loboblancoelbellos/WRO-Competencia-Cayapa/modelado 3d/Soporte para servomotor delantero.jpeg

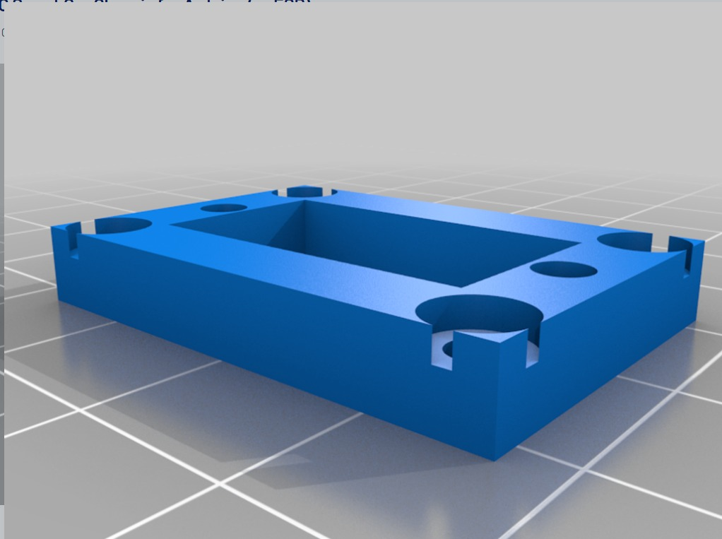
modelado 3d/Soporte para servomotor delantero.jpeg
