loboblancoelbellos/WRO-Competencia-Cayapa/Foto/FOTOGRUPAL.jpeg

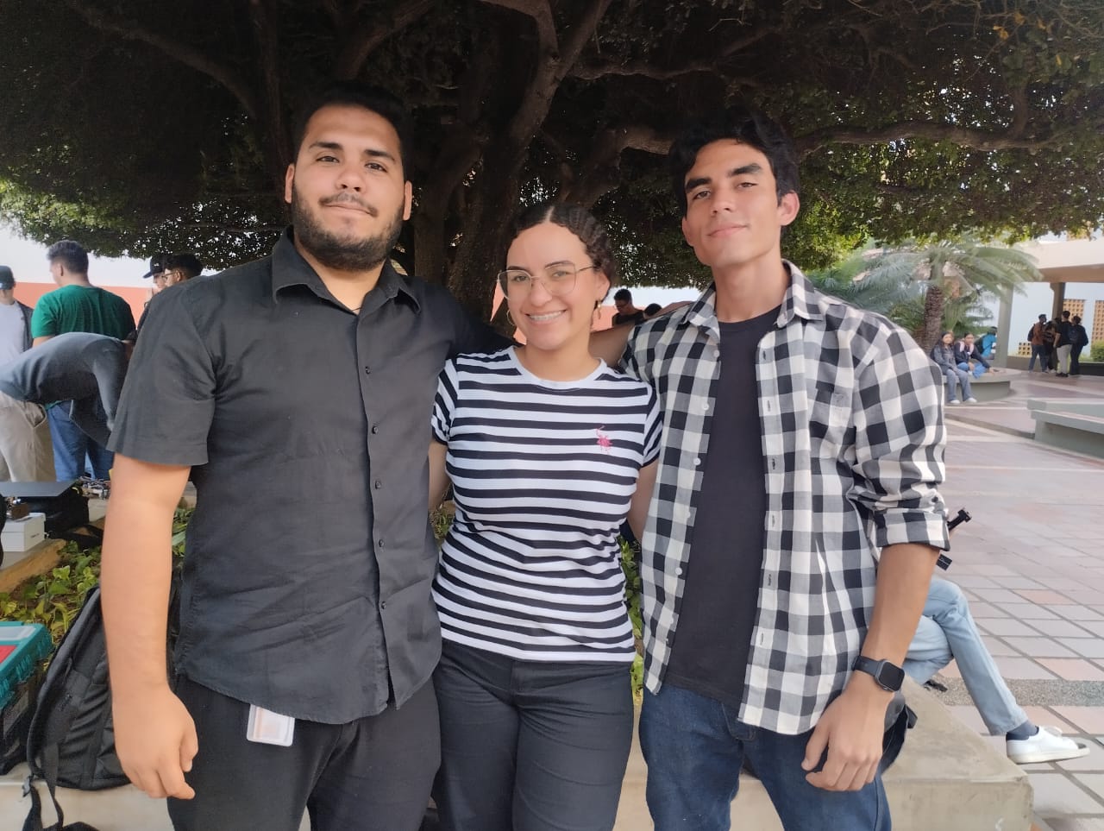
Foto/FOTOGRUPAL.jpeg
