loboblancoelbellos/WRO-Competencia-Cayapa/README.md

# 🚀 WRO 2026 Future Engineers: Equipo Cayapa - Robot "Dinoco"

equipo cayapa2026-09-06 at 17 40 40

> *Vehículo autónomo de diseño compacto desarrollado por el equipo **Cayapa** para competir en la categoría Future Engineers de la World Robot Olympiad (WRO) 2026. Diseñado para optimizar el radio de giro, la estabilidad estructural y la velocidad de procesamiento mediante un microcontrolador ESP32 y una matriz de sensores ultrasónicos.*

---

## 📌 ÍNDICE
1. Introducción y Datos del Equipo
2. Evolución e Iteraciones del Diseño Mecánico
3. Movilidad y Sistema de Tracción/Dirección
4. Arquitectura de Hardware, Sensores y Energía
5. Dimensiones de la Pista y Estrategia de Control
6. Análisis de Fallas, Riesgos y Lecciones Aprendidas
7. Guía de Reproducibilidad y Archivos del Repositorio

---

## 👥 1. Introducción y Datos del Equipo

Este repositorio documenta el desarrollo integral de nuestro vehículo autónomo **"Dinoco"**. Como estudiantes de Ingeniería en Electrónica, aplicamos principios de control automático, diseño mecánico e integración de sistemas electromecánicos para cumplir con la estricta normativa oficial de la WRO 2026.

### Miembros del Equipo

* **Dharma Alexandra Peña Jimenez** - *Tutora y Directora del Proyecto*
  Encargada de la planificación estratégica, gestión de recursos y supervisión general. Su liderazgo fue clave para mantener al equipo enfocado en los objetivos técnicos y asegurar el cumplimiento del cronograma de cara a la competencia.

* **Leontino Jose Medina Di Donato** - *Diseño Mecánico, Modelado e Impresión 3D*
  Especialista en CAD y manufactura aditiva. Su trabajo se centró en la optimización topológica del chasis, la reducción del volumen para mejorar el radio de giro y el diseño de piezas con tolerancias milimétricas para integrar el sistema de rodamientos.

* **Adriana Carolina Palmar Molero** - *Diseño de Circuitos, Sistema de Potencia y Cableado*
  Responsable de la arquitectura de hardware. Desarrolló el diagrama esquemático, seleccionó los componentes de regulación térmica (Buck Converter, Level Shifter) y garantizó un ruteo de cables limpio, seguro y resistente a las vibraciones de la pista.

* **Nilecto Noe Leon Guerere** - *Desarrollo de Software y Algoritmos de Control*
  Arquitecto del código fuente. Aprovechó la capacidad del ESP32 para implementar un control PID de alta frecuencia, diseñando algoritmos de filtrado de señales ultrasónicas para garantizar una navegación fluida, reactiva y 100% autónoma.

---

## 🔄 2. Evolución e Interaciones del Diseño Mecánico

El desarrollo de *Dinoco* ha sido un proceso estrictamente iterativo, donde cada modificación respondió a fallas diagnosticadas durante pruebas dinámicas en pista.

### 2.1. Prototipo 1.0: Chasis RC Modificado y Arquitectura Basada en Arduino Mega

**Motivación y Selección Mecánica Inicial (Ciclo 2025)**

Debido a las restricciones de tiempo en la fase inicial del proyecto para las competencias de 2025, el equipo optó por no diseñar un chasis desde cero. En su lugar, se seleccionó como plataforma de pruebas un chasis comercial de radiocontrol (RC) de dimensiones iniciales de 45 cm de largo por 20 cm de ancho. Para adecuarlo al reglamento de esa temporada, se redujo la longitud recortando la estructura central.

Sistema de Tracción: Transmisión por eje posterior rígido hacia ambas ruedas traseras.

Sistema de Dirección: Servomotor MG995, seleccionado por su elevado par de apriete (torque).

**Diagnóstico Crítico de Fallas (¿Por qué se descartó el Prototipo 2025 para el diseño actual?)**

Evaluar el rendimiento de este primer prototipo fue fundamental para sentar las bases mecánicas y electrónicas del modelo que competirá este año. Las principales deficiencias documentadas fueron:

Radio de Giro Ineficiente: Con dimensiones cercanas al límite máximo, el vehículo requería un radio de viraje sumamente amplio, siendo incapaz de completar curvas de 90° cerradas o ejecutar el estacionamiento autónomo.

Ruido Inductivo (Back-EMF): El servomotor MG995 inyectaba picos de corriente hacia el pin de señal del Arduino Mega, provocando bloqueos aleatorios del programa.

Sobrecarga Térmica y Caídas de Tensión (Brownouts): El regulador LM7805 sufría sobrecalentamiento por la demanda simultánea de los sensores y el servo, ocasionando lecturas erráticas y reinicios constantes.

---

### 2.2. Dinoco (Versión 2.0 / Actual): Optimización Dimensional y Upgrade Electrónico

Tras analizar las limitaciones mecánicas y eléctricas del Prototipo 1.0, rediseñamos la plataforma desde cero para crear **Dinoco 2.0**, enfocándonos en la ergonomía, la velocidad de procesamiento y la modularidad.

**Vista del Chasis Actual:**
-
carrito 2026-09-06 at 17 45 28

---
**Ensamblaje de Componentes:**

adriana ensamblando 2026-09-06 at 17 45 37

---

leontino ensamblando 2026-09-06 at 17 44 20

---

WhatsApp Image 2026-09-06 at 21 21 08

---

* **Reducción Ergonométrica:** La longitud pasó de 45 cm a un tamaño compacto entre **23 cm y 25 cm**, y el ancho se optimizó a **15 cm**. Esta disminución drástica del volumen mejora significativamente la maniobrabilidad del robot dentro de los carriles de la pista.
* **Dirección Simplificada con Rodamientos:** Se rediseñó el tren delantero integrando **rodamientos (rolineras)** en las manguetas de dirección. Esto reduce drásticamente la fricción mecánica y elimina el juego holgado.
* **Migración al ESP32 + Shield Expansor:** Reemplazamos el Arduino Mega por un **ESP32** montado sobre una placa de expansión de pines, aprovechando su arquitectura Dual-Core a 240 MHz para el procesamiento del algoritmo PID.

---

## ⚙️ 3. Movilidad y Sistema de Tracción/Dirección

### 3.1. Tracción Trasera: Motor DC Makeblock 9V (185 RPM)
Motor Makeblock

* **Justificación de Selección:** Proporciona un **alto par motor (torque)** gracias a su caja reductora metálica, manteniendo constante la tracción de las ruedas traseras.
* **Control de Velocidad:** Gobernado a través de señales PWM mediante el controlador Puente H L298N.

### 3.2. Dirección delantera tipo Ackermann con Rodamientos


* **Mecanismo:** Geometría Ackermann equipada con **rodamientos (rolineras)** en los puntos de pivote para minimizar el rozamiento.
* **Actuador:** Servomotor **MG90S con engranajes metálicos**, evitando desgastes por colisión y garantizando un ángulo de giro suave y rápido.

---

## 🔌 4. Arquitectura de Hardware, Sensores y Energía

Para el diseño de **Dinoco 2.0**, realizamos una reestructuración completa de los componentes electrónicos y electromecánicos, basándonos en un análisis de compensaciones (*Trade-offs*).

### 4.1. Unidad de Procesamiento Central (Cerebro)

**ESP32 (Placa de Desarrollo 30 Pines)**

ESP32

* **Función y Ubicación:** Es el cerebro del robot, encargado de ejecutar el control PID y procesar los sensores. Va ubicado en la parte superior del chasis para evitar interferencias.
* **Por qué se cambió:** Reemplaza al Arduino Mega del Prototipo 1.0 (lento y grande). El ESP32 nos da procesamiento Dual-Core a 240 MHz.
* **Ventajas:** Alta velocidad de reloj, conectividad inalámbrica para futura telemetría y tamaño sumamente compacto.
* **Desventajas:** Opera con lógica de 3.3V (a diferencia de los 5V del Arduino), lo que nos obligó a rediseñar la electrónica de sensores para evitar quemar sus pines.

**Shield Expansor para ESP32 (30 Pines)**



* **Función y Ubicación:** Base donde se acopla el ESP32, expandiendo sus pines GPIO a borneras y conectores macho.
* **Por qué se implementó:** En el carro anterior, las conexiones directas o en protoboard generaban falsos contactos con las vibraciones.
* **Ventajas:** Facilita el cableado con terminales Dupont, organiza la distribución de energía y permite sustituir el ESP32 en segundos en caso de falla en los pits.
* **Desventajas:** Aumenta ligeramente la altura de la electrónica principal.

### 4.2. Adaptación y Regulación de Energía

**Conversor de Nivel Lógico (Level Shifter Bidireccional)**



* **Función y Ubicación:** Interfaz colocada entre los sensores ultrasónicos y el ESP32.
* **Por qué se implementó:** El ESP32 solo soporta 3.3V en sus entradas, pero el pin Echo de los sensores ultrasónicos envía pulsos de 5V. 
* **Ventajas:** Protege los pines GPIO del microcontrolador de sobretensiones irreversibles, traduciendo de 5V a 3.3V de forma segura.
* **Desventajas:** Añade complejidad al cableado del esquemático y requiere ser alimentado con ambos voltajes simultáneamente.

**Regulador de Voltaje LM2596 (Buck Converter / Step-Down)**



* **Función y Ubicación:** Reduce el voltaje de las baterías (11.1V) a un bus estable y seguro de 5V para la lógica y sensores.
* **Por qué se cambió:** Reemplaza al regulador lineal LM7805 del Prototipo 1.0 que se sobrecalentaba y apagaba el robot.
* **Ventajas:** Al ser un regulador conmutado, tiene una eficiencia de hasta 92%, no se sobrecalienta fácilmente y permite ajustar el voltaje.
* **Desventajas:** Puede introducir un leve ruido de conmutación de alta frecuencia en la línea de alimentación.

**Baterías 18650 (x3) y Portabaterías (Holder)**

Baterías 18650

* **Función y Ubicación:** Fuente de energía principal. Alojadas en la parte inferior trasera del chasis para mantener el centro de gravedad bajo.
* **Por qué se eligieron:** Proveen **11.1V nominales**. Su alta capacidad de descarga soporta los picos de arranque del motor trasero sin causar reinicios en el procesador.
* **Ventajas:** Recargables, altísima densidad energética y mantienen un voltaje estable por más tiempo.
* **Desventajas:** Requieren un cargador especializado y balanceo de celdas; un cortocircuito puede ser peligroso.

### 4.3. Actuadores y Mecánica de Tracción

** Puente H L298N**

Motor y L298N

* **Función y Ubicación:** El motor provee la tracción en el eje trasero sólido. El driver L298N controla su sentido de giro y velocidad mediante PWM.
* **Por qué se conservaron:** Fueron las únicas piezas reutilizadas del Prototipo 1.0. Desarrollar un diferencial desde cero exigía un tiempo del que no disponíamos.
* **Ventajas:** La caja reductora ofrece excelente torque. El driver L298N es robusto, tiene disipador térmico y aísla el ruido del motor.
* **Desventajas:** El eje rígido obliga a un ligero arrastre de las ruedas traseras en curvas cerradas.

**Servomotor MG90S**
Servo MG90S

* **Función y Ubicación:** Controla la geometría de dirección Ackermann en el tren delantero.
* **Por qué se cambió:** Reemplaza al MG995 (que generaba rebote eléctrico - Back-EMF).
* **Ventajas:** Formato miniatura que ahorra espacio, pero con **engranajes metálicos (Metal Gear)** que garantizan durabilidad frente a golpes.
* **Desventajas:** Menor torque bruto en comparación con el MG995, pero se compensó aliviando la mecánica de la dirección.

**Rodamientos (Rolineras) 608 y 687ZZ**




* **Función y Ubicación:** Instalados en los ejes y articulaciones (manguetas) del sistema de dirección impreso en 3D.
* **Por qué se implementaron:** El Prototipo 1.0 usaba fricción directa plástico con plástico, lo que hacía que el giro fuera tosco.
* **Ventajas:** Reducen la fricción a casi cero, mejoran drásticamente la suavidad del giro y alargan la vida útil del MG90S.
* **Desventajas:** Requieren tolerancias de impresión 3D extremadamente precisas.

### 4.4. Sensores de Entorno

**Matriz de Sensores Ultrasónicos HC-SR04 (x3)**

Sensor HC-SR04

* **Función y Ubicación:** Sistema de detección primario. Uno frontal para detectar esquinas/muros finales y dos laterales para el control PID de seguimiento de carril.
* **Por qué se conservaron:** A pesar del ruido que presentan, con los algoritmos de filtrado correctos aplicados ahora en el ESP32, son suficientes.
* **Ventajas:** Económicos, fáciles de reemplazar y cubren perfectamente el rango de medición que requiere la pista.
* **Desventajas:** Sonido divergente (el haz se ensancha y puede rebotar mal si el carro choca en ángulo). 

---

## 🎯 5. Dimensiones de la Pista y Estrategia de Control

El diseño de *Dinoco 2.0* se adaptó estrictamente a las especificaciones del campo de juego descritas en el reglamento oficial de la WRO 2026 Futuros Ingenieros:

* **Área Total del Campo:** 3000 mm x 3000 mm (3 m x 3 m).
* **Ancho de Carril:** Carriles de circulación delimitados por paredes exteriores e interiores con secciones de entre 400 mm y 500 mm.

### Algoritmo de Control PID Adaptado
Heredamos y refinamos el algoritmo de **Control Proporcional-Integrativo-Derivativo (PID)** del software anterior:

1. **Lectura y Filtrado:** El ESP32 consulta cíclicamente los sensores ultrasónicos, aplicando un filtro por media móvil para eliminar picos erróneos.
2. **Cálculo de Error de Centrado:** Se determina la diferencia de distancia entre la pared izquierda y derecha: Error = Distancia Izquierda - Distancia Derecha.
3. **Corrección Angular:** La salida del PID ajusta en tiempo real la señal PWM hacia el servomotor de dirección.

---

## 🧠 6. Análisis de Fallas, Riesgos y Lecciones Aprendidas

> ⚡ **Problema: Caídas de voltaje (Brownouts) al arrancar el motor**
> * **Causa:** El motor DC exigía un pico de corriente al arrancar que bajaba la tensión por debajo de 3.3V, reiniciando el microcontrolador.
> * **Solución:** Separamos las líneas de alimentación implementando el LM2596.

> 🔊 **Problema: Lecturas erráticas en los sensores ultrasónicos**
> * **Causa:** El ruido acústico del aire y la vibración estructural generaban picos de lectura falsos.
> * **Solución:** Diseñamos una función de software que toma muestras consecutivas, descarta los valores extremos y calcula
## ⚡ 7. Esquemático y Diagrama Eléctrico

Para garantizar la reproducibilidad del proyecto y documentar la arquitectura de hardware, se diseñó el siguiente diagrama eléctrico que detalla la distribución de energía y el flujo de señales lógicas.

WhatsApp Image 2026-09-05 at 21 27 21

### 7.1. Distribución de Energía (Power Management)
El sistema cuenta con un circuito de alimentación segmentado para proteger la electrónica de control de los picos de consumo de los actuadores:
* **Fuente Principal:** Pack de 3 baterías 18650 (11.1V nominales) con un interruptor general (Switch 1).
* **Etapa de Potencia:** Los 11.1V van directos al módulo L298N para maximizar el torque del motor DC trasero.
* **Etapa de Control:** El voltaje se regula a través del módulo **LM2596 (Buck Converter)**, reduciéndolo a 5V estables. Esta línea pasa por un segundo interruptor (Switch 2) y alimenta de forma segura el ESP32 (vía pin VIN), el Servomotor MG90S y los sensores ultrasónicos.

### 7.2. Acondicionamiento de Señales lógicas
Dado que el ESP32 opera con lógica de 3.3V y los sensores ultrasónicos HC-SR04 devuelven pulsos de 5V en su pin *Echo*, se integró un **Conversor de Nivel Lógico Bidireccional (Level Shifter)** en el centro del circuito. Esto protege los pines GPIO del microcontrolador de sobretensiones.

### 7.3. Tabla de Conexiones (Pinout)

A continuación, se mapean las conexiones entre el microcontrolador ESP32 y los periféricos, basándose en el diagrama eléctrico oficial del equipo:

| Componente | Pin del Periférico | Pin ESP32 (GPIO) | Observaciones |
| :--- | :--- | :--- | :--- |
| **Sensor Ultrasónico (Frontal)** | TRIG <br> ECHO | GPIO 27 <br> GPIO 14 | *ECHO pasa por el Level Shifter (5V -> 3.3V)* |
| **Sensor Ultrasónico (Izquierdo)** | TRIG <br> ECHO | GPIO 15 <br> GPIO 2 | *ECHO pasa por el Level Shifter (5V -> 3.3V)* |
| **Sensor Ultrasónico (Derecho)** | TRIG <br> ECHO | GPIO 13 <br> GPIO 12 | *ECHO pasa por el Level Shifter (5V -> 3.3V)* |
| **Driver L298N (Motor DC)** | ENA (PWM) <br> IN1 <br> IN2 | GPIO 25 <br> GPIO 33 <br> GPIO 32 | *Control de velocidad y sentido del eje trasero* |
| **Servomotor MG90S** | Señal (PWM) | GPIO 26 | *Control del ángulo de dirección Ackermann* || Señal (PWM) | GPIO XX | *Control de ángulo de dirección Ackermann* |

---

### 7.4. Diagramas de Hojas Técnicas (Datasheets)
Para justificar las decisiones de diseño y los límites de operación eléctrica, nos basamos en la documentación oficial (Datasheets) de nuestros componentes de mayor impacto estructural:

**Microcontrolador ESP32 (Arquitectura de Pines)**

> pinout-1 esp 30 pines

* **Justificación técnica:** Este diagrama valida nuestra distribución de señales PWM por hardware y las entradas tolerantes exclusivamente a 3.3V, lo que determinó el uso del conversor lógico.

**Driver de Motor L298N (Diagrama de Bloques Interno)**

> Modulo-L298N-esquema

* **Justificación técnica:** El esquema interno de puentes H bipolares demuestra su capacidad para soportar los picos de corriente del motor DC sin afectar el bus de voltaje lógico.

---

## 📂 8. Guía de Reproducibilidad y Archivos del Repositorio
*( archivos STL de impresión 3D, etc.) 
WhatsApp Image 2026-09-06 at 7 58 36 PM
WhatsApp Image 2026-09-06 at 7 58 36 PM (9)
WhatsApp Image 2026-09-06 at 7 58 36 PM (8)
WhatsApp Image 2026-09-06 at 7 58 36 PM (7)
WhatsApp Image 2026-09-06 at 7 58 36 PM (6)
WhatsApp Image 2026-09-06 at 7 58 36 PM (5)
WhatsApp Image 2026-09-06 at 7 58 36 PM (4)
WhatsApp Image 2026-09-06 at 7 58 36 PM (3)
WhatsApp Image 2026-09-06 at 7 58 36 PM (2)
WhatsApp Image 2026-09-06 at 7 58 35 PM
WhatsApp Image 2026-09-06 at 7 58 36 PM (1)

## 🏁 . Demostración en Pista (Pruebas Dinámicas)

El siguiente video documenta una de las pruebas de navegación autónoma exitosas de **Dinoco 2.0**. En él se puede observar la respuesta en tiempo real del algoritmo PID manteniendo el vehículo centrado en el carril y ejecutando los giros utilizando la geometría Ackermann.

> **▶️ [VIDEO DE DEMOSTRACIÓN]** >

https://github.com/user-attachments/assets/c235062e-5041-47fe-a08f-28b0c7b19106

___

## 📸. Galería: Vehículo Ensamblado (Ready to Race)

A continuación, se presenta el resultado final del desarrollo: **Dinoco 2.0** completamente ensamblado, cableado y listo para las pruebas oficiales de la WRO 2026.

<div align="center">
  Carro Listo 1
  Carro Listo 2
</div>
<br>
<div align="center">
  Carro Listo 3
  Carro Listo 4
</div>
<br>
<div align="center">
  Carro Listo 5
  Carro Listo 6
</div>
<br>
<div align="center">
  Carro Listo Detalle 1
  Carro Listo Detalle 2
</div>
