loboblancoelbellos/WRO-Competencia-Cayapa/Foto/Foto Grupal( equipo + tutora).jpeg

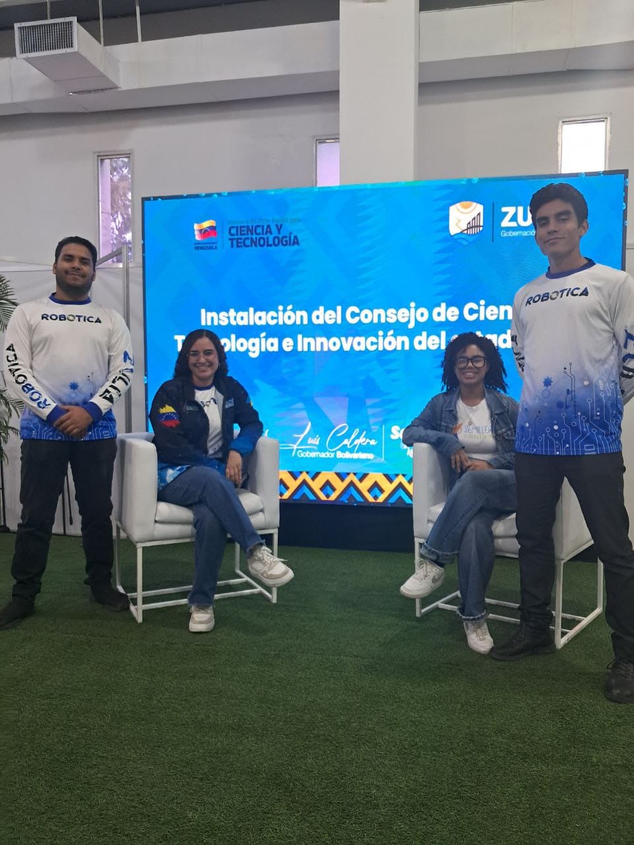
Foto/Foto Grupal( equipo + tutora).jpeg
