loboblancoelbellos/WRO-Competencia-Cayapa/modelado 3d/Adaptador de rueda a eje delantera.jpeg

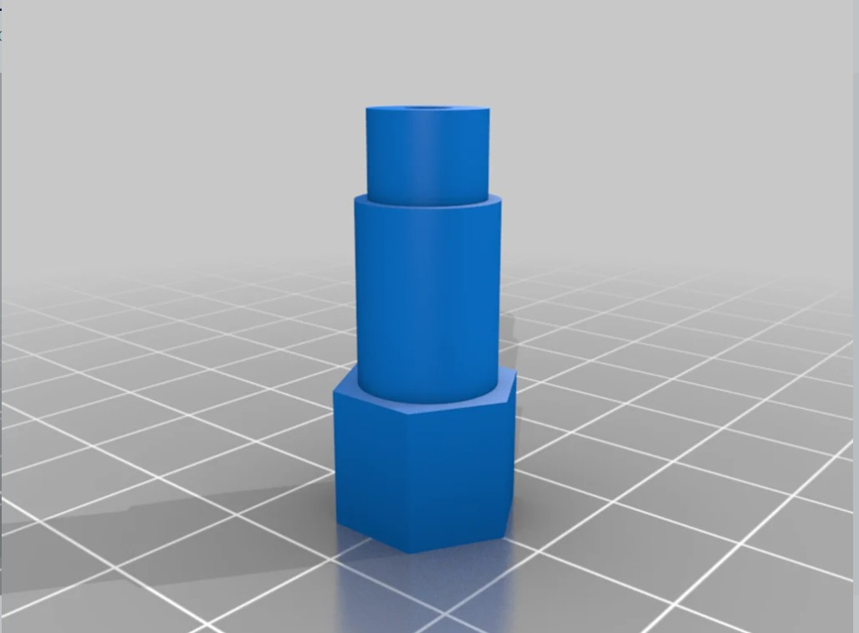
modelado 3d/Adaptador de rueda a eje delantera.jpeg
