loboblancoelbellos/WRO-Competencia-Cayapa/modelado 3d/Barra Principal de direccion.jpeg

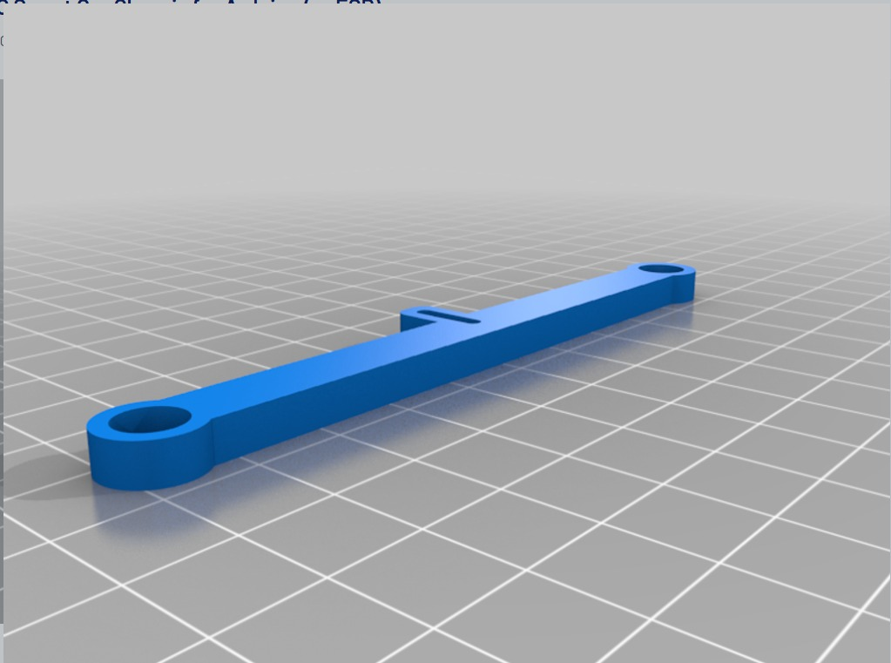
modelado 3d/Barra Principal de direccion.jpeg
