loboblancoelbellos/WRO-Competencia-Cayapa/modelado 3d/Base soporte delantera de sireccion 1.jpeg

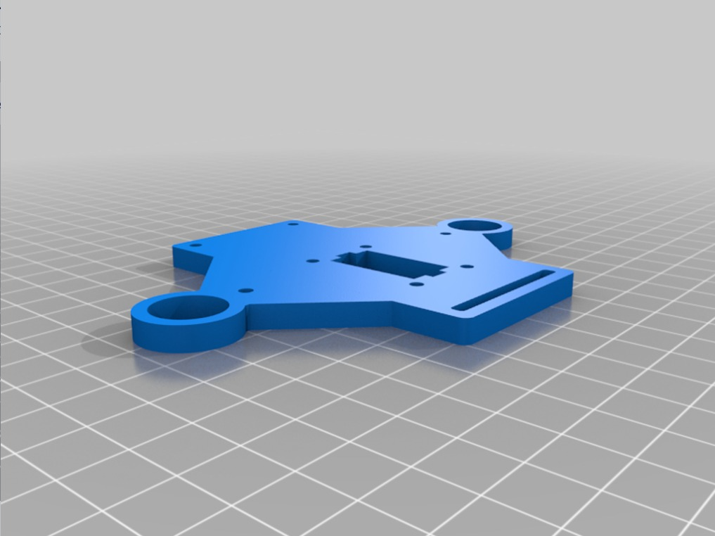
modelado 3d/Base soporte delantera de sireccion 1.jpeg
