loboblancoelbellos/WRO-Competencia-Cayapa/modelado 3d/buje para direccion delantera.jpeg

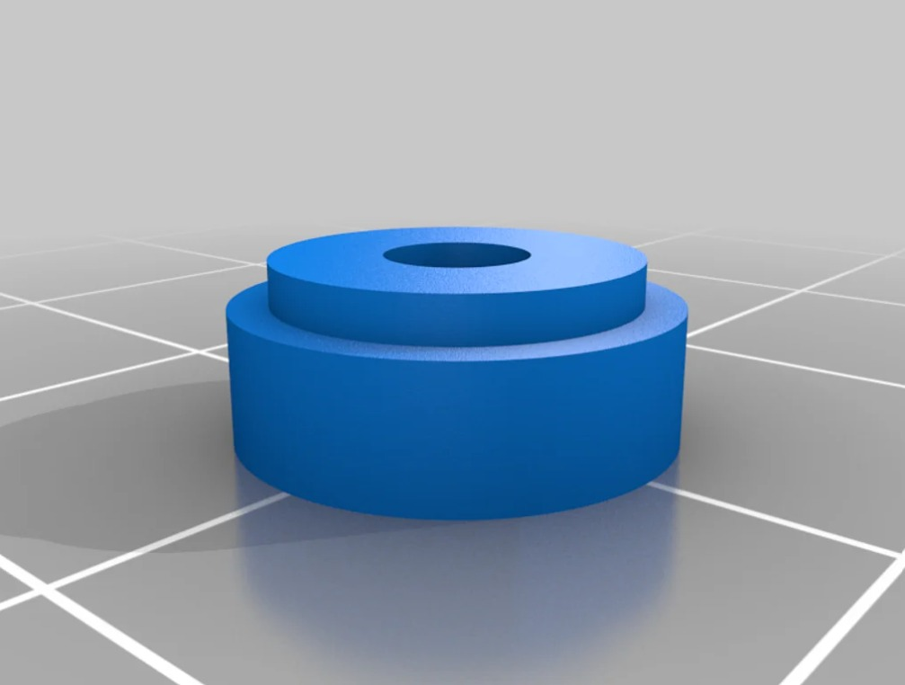
modelado 3d/buje para direccion delantera.jpeg
