loboblancoelbellos/WRO-Competencia-Cayapa/modelado 3d/Ejemplo de soportes de base secundaria parte baja de direccion delantera.jpeg

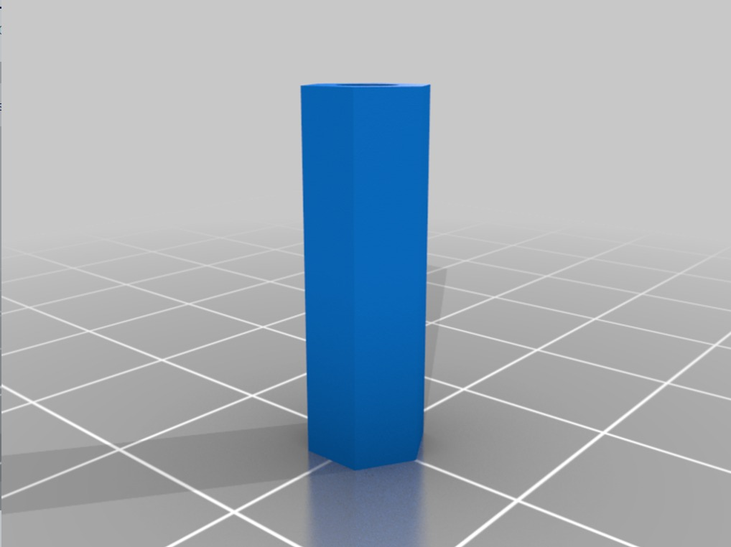
modelado 3d/Ejemplo de soportes de base secundaria parte baja de direccion delantera.jpeg
