loboblancoelbellos/WRO-Competencia-Cayapa/modelado 3d/soporte de la direccion delantera 2.jpeg

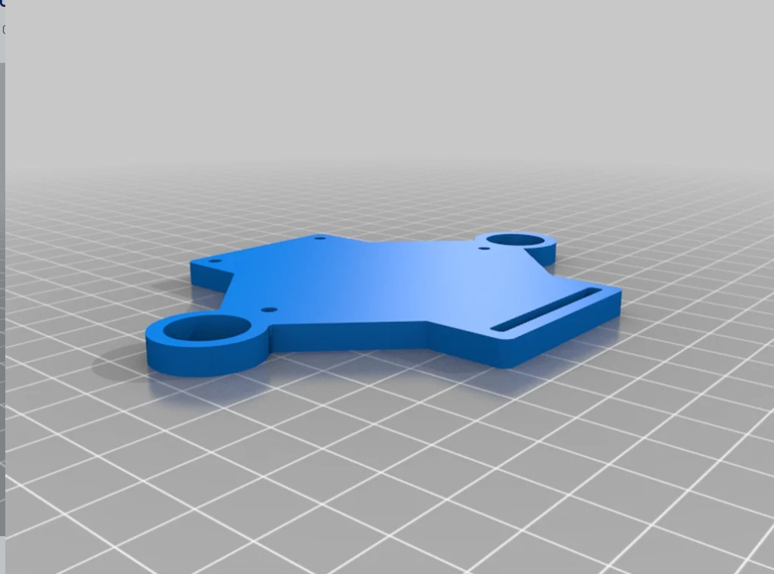
modelado 3d/soporte de la direccion delantera 2.jpeg
