loboblancoelbellos/WRO-Competencia-Cayapa/modelado 3d/soporte de Rolinera 608delantera dirección .jpeg

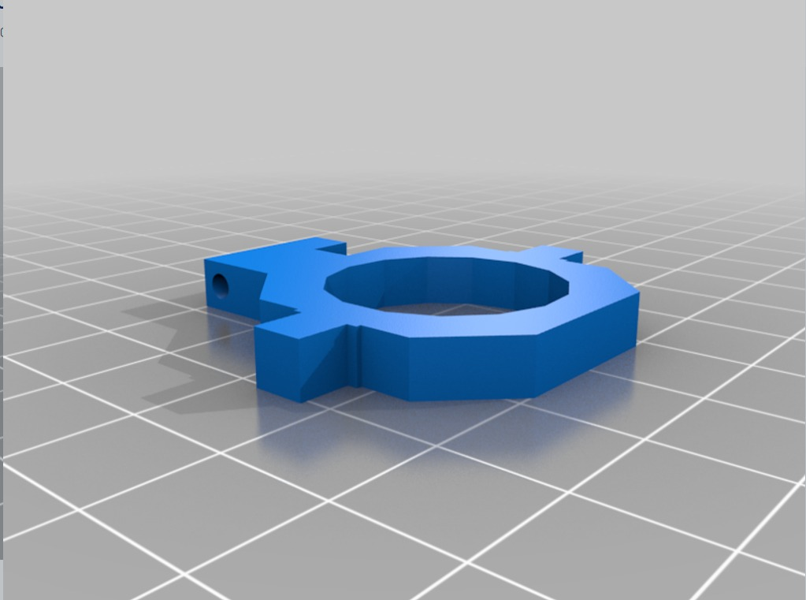
modelado 3d/soporte de Rolinera 608delantera dirección .jpeg
