loboblancoelbellos/WRO-Competencia-Cayapa/esquema de armado/Ensamblade de Motor.md

## ensamblaje de motor 

Componentes: 10 tornillos M3 de 8mm, 8 tuercas M3 y 2 rodamientos de 12x18x4mm

Piezas impresas: “Rear-Frame_L”, “Rear-Frame_R_A” o “Rear-Frame_R_B”, “Rear-Frame-Lower”, “Rear-Axis”, “Clamp” x2, “Rear-Flex-1”, “Rear-Flex-2” y “Rear-Frame-Backing”

Bloque trasero. Colocamos los rodamientos en “Rear-Frame_L” y “Rear-Frame_R”. Unimos una de estas dos últimas con “Rear-Frame-Lower” con 2 tuercas y 2 tornillos M3 de 8mm, introducimos el eje “Rear-Axis” a través del rodamiento y unimos la otra pieza con otras 2 tuercas y otros 2 tornillos M3 de 8mm. Después unimos “Rear-Flex-1” y uno de los “Clamp” a “Rear-Frame-Lower” por la parte delantera (la mas alta) con 2 tuercas y 2 tornillos M3 de 8mm haciendo un sandwich y hacemos lo mismo con “Rear-Flex-2” y otro “clamp” en la parte trasera. Para terminar reforzamos el conjunto con la pieza “Rear-Frame-Backing” y 2 tornillos M3 de 8mm.

La pieza “Rear-Frame_R” es la pieza donde se ancla el motor. Esta pieza funciona en conjunto a uno de los dos piñones. Hay dos versiones de estas piezas, las dos son buenas, puedes utilizar la que mejor te funcione a ti. La más sencilla y la que yo recomiendo es la versión “A”. La pieza donde va el motor es plana y el piñón se coloca introduciendo dos tornillos en el sentido del eje del motor, y que entran tan justos que ejercen fuerza sobre el eje para que el piñón quede fijo. En la versión “B”, la pieza donde se sujeta el motor lleva dos salientes para ganar espacio para esta versión del piñón. Este piñón lleva dos huecos para introducir dos tuercas por las que pasarán dos tornillos M3 de 5mm. Estos tornillos se apretarán contra el eje del motor para que quede sujeto. En este paso solo necesitamos la pieza “Rear-Frame_R” pero necesitarás poner la “A” o la “B” dependiendo del piñón que vayas a usar, “Gear-1_A” o “Gear-2_B”.

(http://https://dukedoks.com/wp-content/uploads/2024/05/Instrucciones_01_DKS-Basic_02-0-1536x864.jpg)

(http://https://dukedoks.com/wp-content/uploads/2024/05/Instrucciones_01_DKS-Basic_02-1-1536x864.jpg)

(http://https://dukedoks.com/wp-content/uploads/2024/05/Instrucciones_01_DKS-Basic_02-2-1536x864.jpg)
