loboblancoelbellos/WRO-Competencia-Cayapa/(commit log)

2026-06-09 Update MG90S servo motor section in README
    Added a new image and description for the MG90S servo motor.
2026-06-09 Update heading for HC-SR04 distance sensor
2026-08-19 Update README with sensor issue solutions
    Removed outdated solutions and added new software function for averaging sensor readings.
2026-09-06 Update print statement from 'Hello' to 'Goodbye'
2026-09-06 Update fmt.Println message from 'Hello' to 'Goodbye'
2026-09-06 Add vehicle control code and sensor integration
    Added code for vehicle control and ultrasonic sensor readings.
2026-09-06 Refactor servo control for ESP32 with calibration mode
    Updated servo code to use ESP32Servo library and modified pin configuration. Added calibration mode and timer allocation for ESP32.
2026-09-06 Refactor motor control pins and add serial output
2026-09-06 ultrasonic
    Refactor ultrasonic sensor code for better readability and performance. Updated pin configurations and improved distance measurement logic.
2026-09-06 Implement smooth turning and update servo setup
    Added smooth turning functionality and improved servo initialization.
2026-09-06 Rename ![circuit_image](httpsgithub.comuser-attachmentsassets71839ff9-3e16-42c5-935b-3d21ed1a766c).jpg to Diagrama Eléctrico
2026-09-06 Modify image format and enhance flowchart description
    Updated the image format for the electrical diagram and added a description for the flowchart.
2026-09-06 Add flowchart for circuit operational logic
    Added a flowchart illustrating the operational logic of the circuit, detailing the initialization, switch states, and main loop operations.
2026-09-06 Update Armado electrico con Diagrama de flujo.md
2026-09-06 Revise mechanical design evolution and diagnostics
    Updated the README to reflect changes in the mechanical design process and critical diagnostics for the 2025 prototype.
2026-09-06 Update actuator section in README
    Removed specific mention of the DC motor in the actuator section.
2026-09-06 Refine solution for voltage drop problem in README
    Updated the solution for voltage drop issue by removing decoupling capacitors from the explanation.
2026-09-06 Update GPIO pin assignments for ultrasonic sensors
2026-09-07 Remove steering assembly instructions
    Removed detailed assembly instructions for the steering block and components.
2026-09-07 Rename WhatsA9-06 at 19.58.33.jpeg to Adaptador de rueda a eje delantera.jpeg
2026-09-07 Rename WhatsAp9-06 at 19.58.33.jpeg to buje para direccion delantera.jpeg
2026-09-07 Rename WhatsApp Im9-06 at 19.58.33.jpeg to soporte de Rolinera 608delantera dirección .jpeg
2026-09-07 Rename WhatsApp Ima at 19.58.33.jpeg to Ejemplo de soportes de base secundaria parte baja de direccion delantera.jpeg
2026-09-07 Rename WhatsApp Ima19.58.33.jpeg to Base soporte delantera de sireccion 1.jpeg
2026-09-07 Rename WhatsApp Imag 19.58.33.jpeg to Barra Principal de direccion.jpeg
2026-09-07 Rename WhatsApp Image 2026-09-06 19.58.33.jpeg to Soporte para servomotor delantero.jpeg
2026-09-07 Rename WhatsApp Imaget 19.58.33.jpeg to soporte de la direccion delantera 2.jpeg
2026-09-07 Rename Ensamblade de Motor y Direccion.md to Ensamblade de Motor.md
2026-09-07 Update image in README for Ackermann steering section
2026-09-07 Update motor and driver description in README
2026-09-07 Simplify servomotor adjustment steps
    Removed unnecessary steps for adjusting servomotor angle.
2026-09-11 Update README with photos of assembled car
    Added images of the fully assembled car to the README.
2026-09-11 Enhance README with battery and sensor information
    Added images and details for 18650 batteries and ultrasonic sensors in the README.
2026-09-11 Add image and details for L298N motor driver
2026-09-11 Update README with component diagrams and justifications
    Added images and technical justifications for ESP32 and L298N components in the README.
